earlruby/garden-of-d-lights/(commit log)

2019-10-20 Arduino libraries and code for the Garden of d'Lights.
2025-01-01 Made a note on Arduino "Metro" vs "Mega" boards.
2025-01-01 Added notes on heat shrink tubing.
